WeissShahaf/LizardPlusMaze/plusmaze.PNG

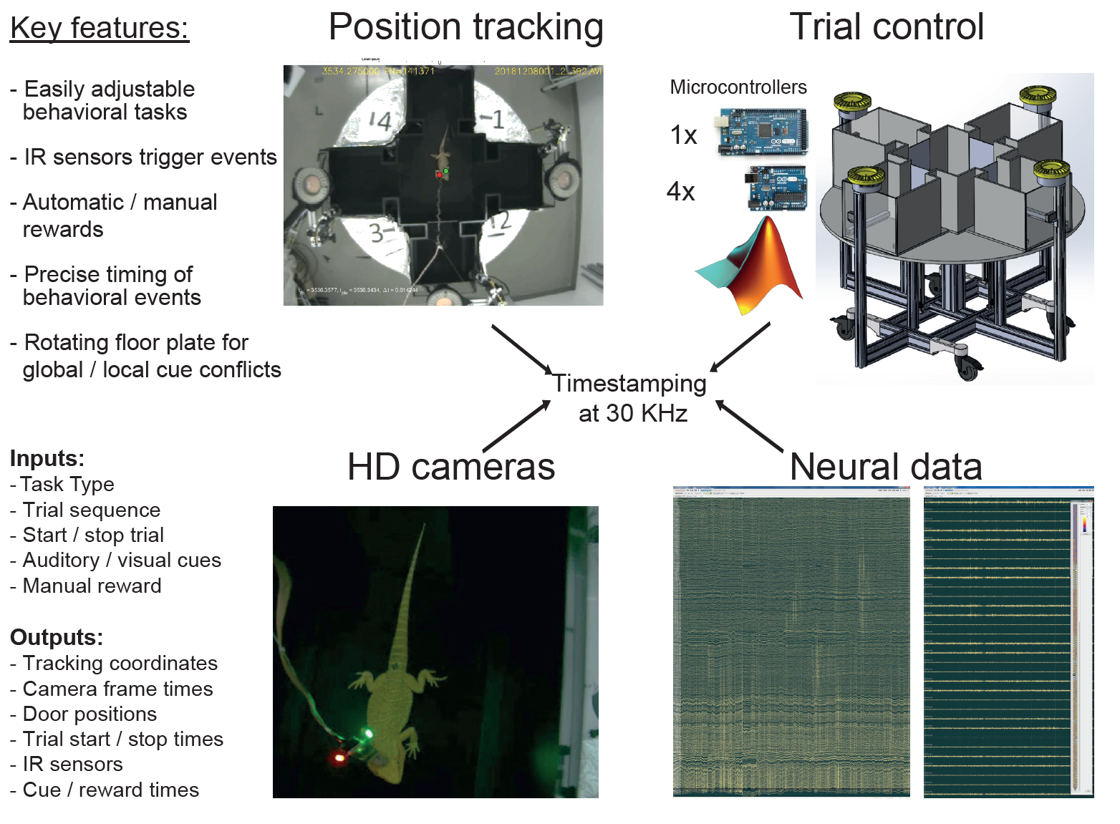
plusmaze.PNG
