WeissShahaf/LizardPlusMaze/README.md

# LizardPlusMaze
version/date: 10.04.2019
Matlab code written by Shahaf Weiss & Friedrich Kretschmer 
Arduino UNO and MEGA folders code written by Shahaf Weiss ,Friedrich Kretschmer & Erik Papuschin 
Arena design files by Guido Schmalbach

repository contains files needed to run & control plus maze arena for lizards from matlab GUI.

plusmaze
