WeissShahaf/LizardPlusMaze/MatlabCode/README.md

# LizardPlusMaze
Drivers for the lizard plus maze (in collaboration with Shahaf Weiss)
