WeissShahaf/LizardPlusMaze/documentation/GUI.pptx

GUI layout

Manual control

Programmed sequences

Program #

Load program

Save program

Dropdown menu

Name1
Name2
Name3
Start New program

Edit menu
Correct sound: 700 Hz, 50 dB
Error sound: 1400 Hz, 50 dB
Proximity setting: 10 cm
Correct arm #__
Correct light:
Error light:

TTL.IN.PLEXON.START timestamp
TTL.OUT.Doors.OPEN timestamp
TTL.OUT.Arm.1 timestamp
TTL.OUT.Correct timestamp
TTL.OUT.Reward timestamp
TTL.OUT.Doors.CLOSE timestamp
TTL.IN.PLEXON.STOP timestamp

Arm #1

Arm #2

Arm #3

Edit

Arm #4

Start

Stop

Open doors

Close doors

Run program

Stop program

Indicators layout

Correct

Error

1

4

2

3

## Slide 2

Output path:

Save as

Connect to Cheetah

Cheetah TTL events

Start recording

Animal#:free text

Task: Place/ response drop down menu

Trial | Start arm | Goal arm | Choice arm | Choice time | Comment
1 | 4 | 2 | 2 | MM:SS
2 | 3 | 2
3 | 1 | 2
4 | 3 | 2
5 | 1 | 2
6 | 4 | 2
7 | 1 | 2
8 | 4 | 2
9 | 3 | 2
10 | 1 | 2

TTL.IN.PLEXON.START timestamp
TTL.OUT.Doors.OPEN timestamp
TTL.OUT.Arm.1 timestamp
TTL.OUT.Correct timestamp
TTL.OUT.Reward timestamp
TTL.OUT.Doors.CLOSE timestamp
TTL.IN.PLEXON.STOP timestamp

Connect to Arduinos

Correct

Start Trial

No choice

End Trial

Indicators layout

1

Error

4

3

2

Stop recording

Live plot indicating current:
Door status, Start/goal/error ,Reward given/ error detected, IR activated

IR sensor : 1/2/3 drop down menu

Doors

state

Arm1

Start/Error/Goaldrop down menu

Arm2

Start/Error/Goaldrop down menu

Arm3

Start/Error/Goaldrop down menu

Arm4

Start/Error/Goaldrop down menu

## Slide 3

Output path: default: storage3\weissShahaf\plus_maze\

Day integer | Experimenter | Animal ID text | Task type drop down | Max trial time number | Temp number | Comment text
20180620 | SW | GLL00392 | Place / response / Visual Cue | Default 10 (minutes) | 27

Trial integer | IR position Drop down | Start arm integer | Goal arm integer | Choice arm integer | latency to choice | Comment text
1 | 1/2/3 | 4 | 2 | 2 If max time- autofill “5” | MM:SS autofill from 1st IR . Or NaN if no choice made
2 | | 3 | 2
3 | | 1 | 2
4 | | 3 | 2
5 | | 1 | 2
6 | | 4 | 2
7 | | 1 | 2
8 | | 4 | 2
9 | | 3 | 2
10 | | 1 | 2
…
20

Reset

Connect to Cheetah-check Netcom connection

Start cheetah recording

Connect to Arduinos
Check Serial ports

Stop cheetah recording

Static parameters

Generates table values

Trial parameters

Add trial

Start Trial

Cheetah Connected ON/OFF

Cheetah recording ON/OFF

Arduino connection
ON/OFF

Waiting/
Trial

End Trial

Changes apply to
upcoming trials

Save

Door open / closed

Arm is start/error/goal
Sensors active/inactive

1

4

2

3

Reward ON/OFF

Notes: Can combine ready and start

On save, creates folders in Output path:
path\animal\day\HH_MM_SS_cheetah
path\animal\day\HH_MM_SS_videos
path\animal\day\HH_MM_SS_behavior<- save .mat file here
On START Apply current line parameters to the maze

After END, set all arms as starting arm- do not give reward/error signals

Place task- starting arm should pseudorandomized to contain similar ratios of arms (1:3) on every 3 trials. For 10/20 trials
Goal arm is 2

Response task- starting arm should pseudorandomized to contain similar ratios of arms (1:4) on every 4 trials. For 10/20 trials
Goal arm is start arm-1 except for arm 1->goal is 4

Cue task- start and goal are randomized, cannot be equal, reward light is ON for the goal arm, and flashes when animal enters arm (requires connection to UNOs)

Start after start / end after end should have no effect! And no TTLs sent!
Start/stop cheetah should be ignored if already pressed

Highlight current trial line

Plot should update for changes in: Door status, Start/goal/error ,Reward given/ error detected, IR activated

Autosave table info to temp file on “E:\temp_maze_files” drive every 5 minutes ? Will slow down the PC too much?
