WeissShahaf/LizardPlusMaze/MazeDesignFiles/PinLayouts/arduino pinlayout.xlsx

Arduino UNO |  | Arduino Mega
Digital Pin |  | Digital Pin
0 | NC | 0 | NC
1 | NC | 1 | NC
2 | Switch Arm | 2 | Input door 1 open
3 | Motor pwmA | 3 | Input door 1 close
4 | Switch Analogsensor 1 | 4 | Input door 2 open
5 | Switch Analogsensor 2 | 5 | Input door 2 close
6 | Green LED | 6 | Input door 3 open
7 | Buzzer | 7 | Input door 3 close
8 | Signal motor drive | 8 | Input door 4 open
9 | Analogsensor active | 9 | Input door 4 close
10 | Switch Analogsensor 3 | 10 | start_arm_1
11 | Motor pwmB | 11 | start_arm_2
12 | Motor direction A | 12 | start_arm_3
13 | Motor direction B | 13 | NC
 |  | 14 | NC
 |  | 15 | NC
Analog Pin |  | 16 | NC
A0 | Signal from analogsensor 1 | 17 | NC
A1 | Signal from analogsensor 2 | 18 | NC
A2 | Signal from analogsensor 3 | 19 | NC
A3 | NC | 20 | NC
A4 | NC | 21 | NC
A5 | NC | 22 | Output door 1 open
 |  | 23 | Output door 1 close
 |  | 24 | Output door 2 open
 |  | 25 | Output door 2 close
 |  | 26 | Output door 3 open
 |  | 27 | Output door 3 close
 |  | 28 | Output door 4 open
 |  | 29 | Output door 4 close
 |  | 30 | NC
 |  | 31 | NC
 |  | 32 | NC
 |  | 33 | NC
 |  | 34 | NC
 |  | 35 | NC
 |  | 36 | NC
 |  | 37 | NC
 |  | 38 | NC
 |  | 39 | Select analogsensor 1
 |  | 40 | Select analogsensor 2
 |  | 41 | Select analogsensor 3
 |  | 42 | target_arm_1
 |  | 43 | target_arm_2
 |  | 44 | target_arm_3
 |  | 45 | target_arm_4
 |  | 46 | TRIAL_START
 |  | 47 | TRIAL_END
 |  | 48 | start_arm_4
 |  | 49 | NC
 |  | 50 | NC
 |  | 51 | NC
 |  | 52 | NC
 |  | 53 | NC
