WeissShahaf/LizardPlusMaze/MazeDesignFiles/PinLayouts/Verkabelung.xlsx

Arduino Pin | 1: D-SUB 15 Buchse Futterautomat |  |  |  |  | RGB Led | Farbe
 |  |  |  |  |  | Pin
 | Pin: | Bezeichnung: | Farbe: |  |  | Din Arduino Pin | Rot
1 | 1 | 5V | Rot |  |  | 5V | Gruen
8-10 | 2 | 5V Analog Sensor 1 | Rot |  |  | GND | Schwarz
 | 3 | 5V Analog Sensor 2 | Rot
 | 4 | 5V Analog Sensor 3 | Rot
 | 5 | NC
 | 6 | NC
6 | 7 | NC
7 | 8 | NC
3 | 9 | Signal Analogsensor 1 | Grau
4 | 10 | Signal Analogsensor 2 | Braun
5 | 11 | Signal Analogsensor 3 | Gelb
 | 12 | GND | Schwarz
 | 13 | GND Analogsensor 1 | Schwarz
 | 14 | GND Analogsensor 2 | Schwarz
 | 15 | GND Analogsensor 3 | Schwarz
 | 2: D-SUB 15 Stecker Futterautomat |  |  |  | 7: D-SUB 15 Stecker Arduino Mega Box |  |  |  |  | 3: D-SUB 25 Stecker Arudino Mega BoX |  |  | 5: D-SUB 25 Buchse Control BoX
 | Pin: | Bezeichnung: |  |  | Pin: | Bezeichnung: |  |  | Pin: | Pin: | Bezeichnung: |  | Pin: | Bezeichnung:
 | 1 | 5V Arm/Motor drehen | ← |  | 1 | 5V Arm | ← | 3: D-SUB 25 Stecker Arudino Mega BoX | 1-8 | 1 | 5V | ← | 1 | 5V
 | 2 | Matlab UI Arm 1-4 AI3 |  |  | 2 | Matlab UI Arm 1-4 AI3 |  |  |  | 2 | 5V | ← | 2 | 5V
 | 3 | Freigabe Analog Sensor 1 | ← |  | 3 | Freigabe Analog Sensor 1 | ← | 3: D-SUB 25 Stecker Arudino Mega BoX | 17 | 3 | 5V | ← | 3 | 5V
 | 4 | Freigabe Analog Sensor 2 | ← |  | 4 | Freigabe Analog Sensor 2 | ← | 3: D-SUB 25 Stecker Arudino Mega BoX | 18 | 4 | 5V | ← | 4 | 5V
 | 5 | Freigabe Analog Sensor 3 | ← |  | 5 | Freigabe Analog Sensor 3 | ← | 3: D-SUB 25 Stecker Arudino Mega BoX | 19 | 5 | Signal Arm#1 | ← | 5 | Signal Arm#1
 | 6 | Ziel Arm | ← |  | 6 | Ziel Arm | ← | 4: D-SUB 25 Buchse Arudino Mega BoX | 17-20 | 6 | Signal Arm#2 | ← | 6 | Signal Arm#2
 | 7 | Led/Buzzer Arm | → |  | 7 | Led/Buzzer Arm | → | 4: D-SUB 25 Buchse Arudino Mega BoX | 1-8 | 7 | Signal Arm#3 | ← | 7 | Signal Arm#3
 | 8 | lichtschranken | → |  | 8 | lichtschranken | → | 4: D-SUB 25 Buchse Arudino Mega BoX | 1-8 | 8 | Signal Arm#4 | ← | 8 | Signal Arm#4
 | 9 | 9V |  |  | 9 |  |  |  |  | 9 | Door 1 open | ← | 9 | Door 1 open
 | 10 | 9V |  |  | 10 |  |  |  |  | 10 | Door 1 close | ← | 10 | Door 1 close
 | 11 | 9V |  |  | 11 |  |  |  |  | 11 | Door 2 open | ← | 11 | Door 2 open
 | 12 | Matlab UI Arm 1-4 AI4 |  |  | 12 | Matlab UI Arm 1-4 AI4 |  |  |  | 12 | Door 2 close | ← | 12 | Door 2 close
 | 13 | GND |  |  | 13 |  |  |  |  | 13 | Door 3 open | ← | 13 | Door 3 open
 | 14 | GND | ← |  | 14 | GND | ← | 3: D-SUB 25 Stecker Arudino Mega BoX | 20-23 | 14 | Door 3 close | ← | 14 | Door 3 close
 | 15 | GND | ← |  | 15 | GND | ← | 3: D-SUB 25 Stecker Arudino Mega BoX | 20-23 | 15 | Door 4 open | ← | 15 | Door 4 open
 |  |  |  |  |  |  |  |  |  | 16 | Door 4 close | ← | 16 | Door 4 close
 |  |  |  |  |  |  |  |  |  | 17 | Freigabe Analog Sensor 1 | ← | 17 | Freigabe Analog Sensor 1
 |  |  |  |  |  |  |  |  |  | 18 | Freigabe Analog Sensor 2 | ← | 18 | Freigabe Analog Sensor 2
 |  |  |  |  |  |  |  |  |  | 19 | Freigabe Analog Sensor 3 | ← | 19 | Freigabe Analog Sensor 3
 | 8: Arduino Mega |  |  |  |  |  |  |  |  | 20 | GND Arm#1 | ← | 20 | GND Arm#1
 |  |  |  |  |  |  |  |  |  | 21 | GND Arm#1 | ← | 21 | GND Arm#1
 | Pin: | Bezeichnung: |  |  |  |  | Pin: |  |  | 22 | GND Arm#2 | ← | 22 | GND Arm#2
 | 0 | NC |  |  |  |  |  |  |  | 23 | GND Arm#2 | ← | 23 | GND Arm#2
 | 1 | NC |  |  |  |  |  |  |  | 24 | GND | ← | 24 | GND
 | 2 | Eingang Door 1 open | ← | 3: D-SUB 25 Stecker Arudino Mega BoX |  |  | 9 |  |  | 25 | GND | ← | 25 | GND
 | 3 | Eingang Door 1 close | ← | 3: D-SUB 25 Stecker Arudino Mega BoX |  |  | 10
 | 4 | Eingang Door 2 open | ← | 3: D-SUB 25 Stecker Arudino Mega BoX |  |  | 11
 | 5 | Eingang Door 2 close | ← | 3: D-SUB 25 Stecker Arudino Mega BoX |  |  | 12 |  |  |  |  |  |  |  | r
 | 6 | Eingang Door 3 open | ← | 3: D-SUB 25 Stecker Arudino Mega BoX |  |  | 13 |  |  | 4: D-SUB 25 Buchse Arudino Mega BoX |  |  | 6: D-SUB 25 Stecker Control BoX
 | 7 | Eingang Door 3 close | ← | 3: D-SUB 25 Stecker Arudino Mega BoX |  |  | 14
 | 8 | Eingang Door 4 open | ← | 3: D-SUB 25 Stecker Arudino Mega BoX |  |  | 15 |  |  | Pin: | Bezeichnung: |  | Pin: | Bezeichnung:
 | 9 | Eingang Door 4 close | ← | 3: D-SUB 25 Stecker Arudino Mega BoX |  |  | 16 |  |  | 1 | Led/Buzzer Arm#1 | → | 1 | Led/Buzzer Arm#1
 | 10 | Ziel Arm 1 | → | UNO |  |  |  |  |  | 2 | Feeder Sensor Arm#1 | → | 2 | Feeder Sensor Arm#1
 | 11 | Ziel Arm 2 | → | UNO |  |  |  |  |  | 3 | Led/Buzzer Arm#2 | → | 3 | Led/Buzzer Arm#2
 | 12 | Ziel Arm 3 | → | UNO |  |  |  |  |  | 4 | Feeder Sensor Arm#2 | → | 4 | Feeder Sensor Arm#2
 | 13 | Reserve |  |  |  |  |  |  |  | 5 | Led/Buzzer Arm#3 | → | 5 | Led/Buzzer Arm#3
 | 14 | Matlab UI Arm 1 AI3 | → | UNO |  |  |  |  |  | 6 | Feeder Sensor Arm#3 | → | 6 | Feeder Sensor Arm#3
 | 15 | Matlab UI Arm 1 AI4 | → | UNO |  |  |  |  |  | 7 | Led/Buzzer Arm#4 | → | 7 | Led/Buzzer Arm#4
 | 16 | Matlab UI Arm 2 AI3 | → | UNO |  |  |  |  |  | 8 | Feeder Sensor Arm#4 | → | 8 | Feeder Sensor Arm#4
 | 17 | Matlab UI Arm 2 AI4 | → | UNO |  |  |  |  |  | 9 | Feedback Door 1 open | → | 9 | Feedback Door 1 open
 | 18 | Matlab UI Arm 3 AI3 | → | UNO |  |  |  |  |  | 10 | Feedback Door 1 close | → | 10 | Feedback Door 1 close
 | 19 | Matlab UI Arm 3 AI4 | → | UNO |  |  |  |  |  | 11 | Feedback Door 2 open | → | 11 | Feedback Door 2 open
 | 20 | NC |  |  |  |  |  |  |  | 12 | Feedback Door 2 close | → | 12 | Feedback Door 2 close
 | 21 | NC |  |  |  |  |  |  |  | 13 | Feedback Door 3 open | → | 13 | Feedback Door 3 open
 | 22 | Door 1 open | → | Door 1 |  |  |  |  |  | 14 | Feedback Door 3 close | → | 14 | Feedback Door 3 close
 | 23 | Door 1 close | → | Door 1 |  |  |  |  |  | 15 | Feedback Door 4 open | → | 15 | Feedback Door 4 open
 | 24 | Door 2 open | → | Door 2 |  |  |  |  |  | 16 | Feedback Door 4 close | → | 16 | Feedback Door 4 close
 | 25 | Door 2 close | → | Door 2 |  |  |  |  |  | 17 | Ziel Arm 1 | → | 17 | Ziel Arm 1
 | 26 | Door 3 open | → | Door 3 |  |  |  |  |  | 18 | Ziel Arm 2 | → | 18 | Ziel Arm 2
 | 27 | Door 3 close | → | Door 3 |  |  |  |  |  | 19 | Ziel Arm 3 | → | 19 | Ziel Arm 3
 | 28 | Door 4 open | → | Door 4 |  |  |  |  |  | 20 | Ziel Arm 4 | → | 20 | Ziel Arm 4
 | 29 | Door 4 close | → | Door 4 |  |  |  |  |  | 21 | GND Arudino Mega Platinr | → | 21 | GND Arudino Mega Platinr
 | 30 | Feedback Door 4 close | → | 4: D-SUB 25 Buchse Arudino Mega BoX |  |  | 16 |  |  | 22 | GND Arudino Mega Platinr | → | 22 | GND Arudino Mega Platinr
 | 31 | Feedback Door 4 open | → | 4: D-SUB 25 Buchse Arudino Mega BoX |  |  | 15 |  |  | 23 | GND Arm#3 | → | 23 | GND Arm#3
 | 32 | Feedback Door 3 close | → | 4: D-SUB 25 Buchse Arudino Mega BoX |  |  | 14 |  |  | 24 | GND Arm#4 | → | 24 | GND Arm#4
 | 33 | Feedback Door 3 open | → | 4: D-SUB 25 Buchse Arudino Mega BoX |  |  | 13 |  |  | 25 | GND Arm#4 | → | 25 | GND Arm#4
 | 34 | Feedback Door 2 close | → | 4: D-SUB 25 Buchse Arudino Mega BoX |  |  | 12
 | 35 | Feedback Door 2 open | → | 4: D-SUB 25 Buchse Arudino Mega BoX |  |  | 11
 | 36 | Feedback Door 1 close | → | 4: D-SUB 25 Buchse Arudino Mega BoX |  |  | 10
 | 37 | Feedback Door 1 open | → | 4: D-SUB 25 Buchse Arudino Mega BoX |  |  | 9
 | 38 | Matlab UI Arm 4 AI3 | → | UNO
 | 39 | Freigabe Analog Sensor 1 | → | UNO
 | 40 | Freigabe Analog Sensor 2 | → | UNO
 | 41 | Freigabe Analog Sensor 3 | → | UNO
 | 42 | Signal Arm#1 | → | UNO
 | 43 | Signal Arm#2 | → | UNO
 | 44 | Signal Arm#3 | → | UNO
 | 45 | Signal Arm#4 | → | UNO
 | 46 | TRIAL_START | → | UNO
 | 47 | TRIAL_END | → | UNO
 | 48 | Ziel Arm 4 | → | UNO
 | 49 | Matlab UI Arm 4 AI4 | → | UNO
 | 50 | NC
 | 51 | NC
 | 52 | NC
 | 53 | NC
 |  |  |  |  |  |  |  |  |  | D-SUB 25 Buchse Arudino Mega BoX TTL OUT |  |  |  | TTL BOX
 |  |  |  |  |  |  |  |  |  | Pin: | Bezeichnung: |  | Pin: | Bezeichnung:
 |  |  |  |  |  |  |  |  |  | 1 | Door 1 open |  | 1 | TRIAL_START
 |  |  |  |  |  |  |  |  |  | 2 | Door 2 open |  | 2 | TRIAL_END
 |  |  |  |  |  |  |  |  |  | 3 | Door 3 open |  | 3 | Door 1 open
 |  |  |  |  |  |  |  |  |  | 4 | Door 4 open |  | 4 | Door 2 open
 |  |  |  |  |  |  |  |  |  | 5 | Reserve 1 |  | 5 | Door 3 open
 |  |  |  |  |  |  |  |  |  | 6 | LSARM1_ACTIVE |  | 6 | Door 4 open
 |  |  |  |  |  |  |  |  |  | 7 | LSARM2_ACTIVE |  | 7 | LSARM1_ACTIVE
 |  |  |  |  |  |  |  |  |  | 8 | LSARM3_ACTIVE |  | 8 | LSARM2_ACTIVE
 |  |  |  |  |  |  |  |  |  | 9 | LSARM4_ACTIVE |  | 9 | LSARM3_ACTIVE
 |  |  |  |  |  |  |  |  |  | 10 | Reserve 2 |  | 10 | LSARM4_ACTIVE
 |  |  |  |  |  |  |  |  |  | 11 | FEEDER1_ACTIVE |  | 11 | FEEDER1_ACTIVE
 |  |  |  |  |  |  |  |  |  | 12 | FEEDER2_ACTIVE |  | 12 | FEEDER2_ACTIVE
 |  |  |  |  |  |  |  |  |  | 13 | FEEDER3_ACTIVE |  | 13 | FEEDER3_ACTIVE
 |  |  |  |  |  |  |  |  |  | 14 | FEEDER4_ACTIVE |  | 14 | FEEDER4_ACTIVE
 |  |  |  |  |  |  |  |  |  | 15 |  |  | 15 | Reserve 1
 |  |  |  |  |  |  |  |  |  | 16 | TRIAL_START |  | 16 | Reserve 2
 |  |  |  |  |  |  |  |  |  | 17 | TRIAL_END
 |  |  |  |  |  |  |  |  |  | 18
 |  |  |  |  |  |  |  |  |  | 19
 |  |  |  |  |  |  |  |  |  | 20 | GND
 |  |  |  |  |  |  |  |  |  | 21 | GND
 |  |  |  |  |  |  |  |  |  | 22 | GND
 |  |  |  |  |  |  |  |  |  | 23 | GND
 |  |  |  |  |  |  |  |  |  | 24 | GND
 |  |  |  |  |  |  |  |  |  | 25 | GND
