WeissShahaf/LizardPlusMaze/documentation/parts/NLX_PLX.pptx

Basler and behavioral TTLs going to Neuralynx

Plexon signal going into Basler cameras

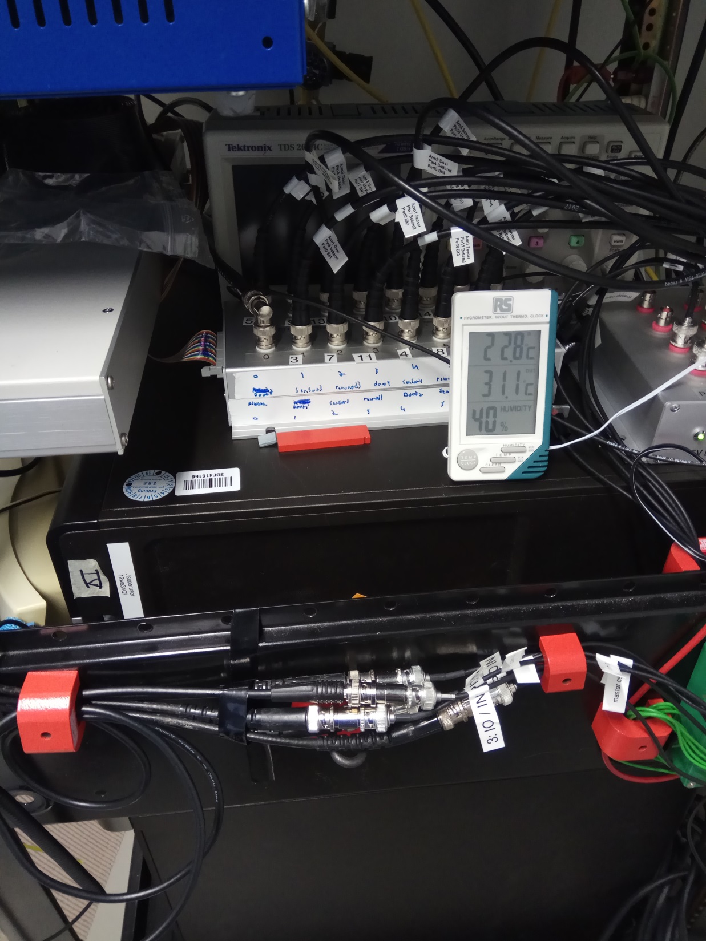
[picture p3: figure]

## Slide 2

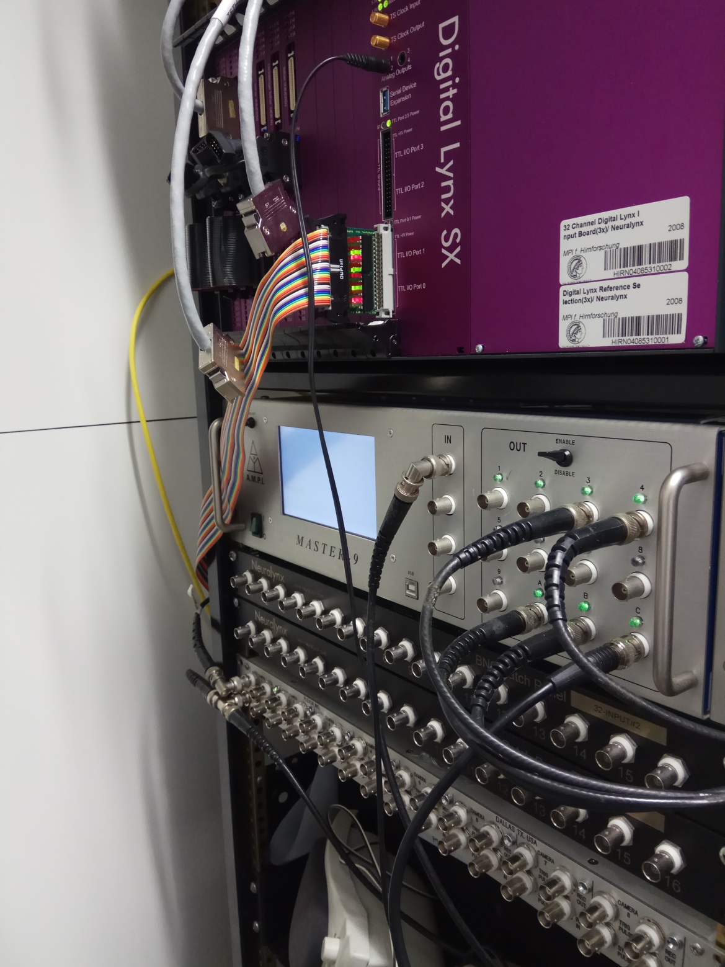
[picture p4: figure]

Signal split to activate Basler cameras

PLEXON frame TTL IN

PLEXON OUT
To Basler cameras

PLEXON OUT TTL
to Neuralynx
