WeissShahaf/LizardPlusMaze/documentation/parts/electronics parts list.xlsx

Sheet: Materialkostenrechnung
 |  | Vorbereitung Bestellung und Materialkostenrechnung
Bestell- datum | Bedarfsanforderung | Bezug (Lager/EK) | Distributor | Beschreibung | Bestell-Nr. | Stück | Einzel-preis | Gesamtpreis Netto | Bemerkung
 |  |  |  |  |  |  |  | 0.00 €
 |  |  |  | Kostenstelle 3210: Eigenverbrauch Elektronik-Werkstatt |  |  |  | 0.00 €
 |  |  |  | Kostenstelle 3211: Wissenschaftlicher Auftrag |  |  |  | 0.00 €
2018-01-30 | 2002799406 | EK | EXP | SparkFun RGB und Gesten-Sensor (APDS- | EXP-R05-420 | 2 | 11.93 € | 23.86 €
2018-02-06 | 2002809236 | EK | MM-Aquaristik | Grässling Rundomatic 400 | 90-GR-0001 | 2 | 55.90 € | 111.80 €
 |  |  |  |  |  |  |  | 0.00 €
2018-03-12 | 2002852921 | EK | Distrelec | Microcontroller Board, Mega2560, R3, A000067, ATmega2560, A000067, Arduino | 110-38-920 | 1 | 34.96 € | 34.96 €
2018-03-12 | 2002852921 | EK | Distrelec | Arduino Motor Shield R3, A000079, SHIELD MODEL MOTOR, Arduino | 110-38-926 | 4 | 19.73 € | 78.92 €
2018-03-12 | 2002852921 | EK | Distrelec | Mikrocontroller Board, Uno, A000066, ATmega328, A000066, Arduino | 110-38-919 | 4 | 19.61 € | 78.44 €
2018-03-12 | 2002852921 | EK | Distrelec | Gehäusehälfte 220 mm | 150-69-916 | 1 | 11.60 € | 11.60 €
2018-03-12 | 2002852921 | EK | Distrelec | Gehäusehälfte 220 mm | 150-69-899 | 2 | 11.01 € | 22.02 €
2018-03-12 | 2002852921 | EK | Distrelec | Front-/ Rückplatte | 150-69-921 | 2 | 8.04 € | 16.08 €
2018-03-12 | 2002852921 | EK | Distrelec | Grove - Summer, Arduino, Raspberry Pi, BeagleBone, Edison, LaunchPad, Mbed, Galiel, 107020000, Seeed Studio | 300-69-924 | 4 | 1.63 € | 6.52 €
2018-03-12 | 2002852921 | EK | Distrelec | LED 5 mm (T13/4) rot/grün/blau Dreifarbig | 175-50-380 | 5 | 0.75 € | 3.75 €
2018-03-12 | 2002852921 | EK | Distrelec | LED 5 mm (T13/4) rot/grün/blau Dreifarbig | 175-10-222 | 5 | 1.93 € | 9.65 €
2018-03-12 | 2002852921 | EK | Distrelec | LED 5 mm (T13/4) rot/grün/blau Dreifarbig | 175-10-221 | 5 | 1.93 € | 9.65 €
2018-03-12 | 2002852921 | EK | Distrelec | Logic-IC SOIC-14, CD4081, CD4081BM, Texas Instruments | 300-18-498 | 10 | 0.20 € | 2.00 €
2018-03-12 | 2002852921 | EK | Distrelec | Logic-IC SC-70-5, SN74AHC1G00, SN74AHC1G00DCKR, Texas Instruments | 300-22-896 | 10 | 0.34 € | 3.40 €
2018-03-12 | 2002852921 | EK | Distrelec | Widerstandsnetzwerk SIL 10 kOhm ± 2 %, 4609X-101-103LF, Bourns | 160-32-478 | 10 | 0.29 € | 2.90 €
2018-03-12 | 2002852921 | EK | Distrelec | Treiber-ICs DIL-18, ULN2803A, ST | 173-13-323 | 3 | 0.50 € | 1.50 €
2018-03-12 | 2002852921 | EK | Distrelec | Präz.-IC-Sockel, DIL 18, 110-87-318-41-001, Preci-Dip | 148-14-802 | 3 | 0.61 € | 1.83 €
2018-03-12 | 2002852921 | EK | Distrelec | Offene Sicherungshalter ø 5 x 20 mm, PTF/15, Stelvio-Kontek | 133-15-017 | 10 | 0.27 € | 2.70 €
2018-03-12 | 2002852921 | EK | Distrelec | Sicherung 5 x 20 mm: 0.125 A flink, RND 17000072, RND Components | 300-43-492 | 10 | 0.15 € | 1.50 €
2018-03-12 | 2002852921 | EK | Distrelec | Leiterplatte Epoxyd 233 x 160 mm | 149-55-332 | 5 | 7.24 € | 36.20 €
2018-03-12 | 2002852921 | EK | Distrelec | Stiftleiste Male 8, RND 205-00629, RND Connect | 300-93-649 | 10 | 0.17 € | 1.70 €
2018-03-12 | 2002852921 | EK | Distrelec | Stiftleiste Male 10, RND 205-00631, RND Connect | 300-93-651 | 10 | 0.22 € | 2.20 €
2018-03-12 | 2002852921 | EK | Distrelec | Stiftleiste Male 36 zweireihig / gerade / ohne Schutzkragen, 61303621121, Würth Elektronik | 300-24-556 | 2 | 1.00 € | 2.00 €
2018-03-12 | 2002852921 | EK | Distrelec | Netzgeräte 24 VDC/2.5 A, OWA-60E-24, Mean Well | 300-43-981 | 1 | 24.37 € | 24.37 €
2018-03-12 | 2002852921 | EK | Distrelec | Konfektioniertes Kabel 3 M8 Buchse M8 Stecker 2 m, 21348081380020, HARTING | 300-34-340 | 8 | 7.03 € | 56.24 €
2018-03-12 | 2002852921 | EK | Distrelec | Stiftleiste Male 6, 6410-06A / 2227-2061, Molex | 143-80-838 | 10 | 0.23 € | 2.30 €
2018-03-12 | 2002852921 | EK | Distrelec | Crimpgehäuse Female 6, 6471-061 / 2201-2065, Molex | 143-80-432 | 10 | 0.12 € | 1.20 €
2018-03-12 | 2002852921 | EK | Distrelec | Crimpkontakt Female 30...22 AWG, 4809C-P914L / 0850-0032, Molex | 143-80-598 | 100 | 0.02 € | 2.00 €
2018-03-12 | 2002853041 | EK | RS | Vishay Optokoppler, 60 mA DC Input Phototransistor Output, 5 kV eff PCB-Montage, DIP 4-Pin | 773-3693 | 10 | 0.17 € | 1.74 €
2018-03-12 | 2002853041 | EK | RS | Murr Elektronik Serie 7000 Stecker gerade, Buchse 3-polig, Buchsenkontakte Crimpanschluss, 4A, Steckbar | 827-2770 | 20 | 7.74 € | 154.78 €
2018-03-12 | 2002853041 | EK | RS | Murr Elektronik Serie 7000 Stecker gerade, Stecker 3-polig, Stiftkontakte, 4A, Steckbar | 797-5768 | 10 | 8.07 € | 80.70 €
2018-03-12 | 2002853041 | EK | RS | Mutter, 718 Serie, M8 x 0.5, für Rundsteckverbinder, Metall | 706-3165 | 20 | 0.94 € | 18.78 €
2018-03-12 | 2002853041 | EK | RS | Lumberg USB 2.0 Kabel schwarz, Stecker USB A / Stecker USB B, Länge 5m | 737-8818 | 1 | 10.62 € | 10.62 €
2018-03-12 | 2002853041 | EK | RS | DC-Adapter gerade 5A, Kabelmontage, Länge 57.1mm, vernickelt, IP68 | 705-1519 | 1 | 8.82 € | 8.82 €
2018-03-12 | 2002853041 | EK | RS | DC Buchse 2,5mm gerade Tafelmontage 5A 30 V dc versilbert, IP68 | 705-1525 | 1 | 7.89 € | 7.89 €
2018-03-12 | 2002853041 | EK | RS | USB-Adapter USB 2.0 A, USB 2.0 B, Buchse auf Buchse, gerade, Tafelmontage | 907-5628 | 1 | 7.21 € | 7.21 €
2018-03-12 | 2002853041 | EK | RS | 0.5MTR USB 2.0 A M B M BLACK | 121-6576 | 1 | 2.08 € | 2.08 €
2018-03-12 | 2002853041 | EK | RS | Nylon Leiterplattenstift, PCB-Stärke 1,6mm, Höhe 9.5mm, PCB-Bohrung 3,2mm | 663-3417 | 40 | 0.15 € | 6.00 €
2018-03-12 | 2002853041 | EK | RS | Nylon Leiterplattenstift, PCB-Stärke 1,6mm, Höhe 11.1mm, PCB-Bohrung 3,2mm | 663-3426 | 40 | 0.15 € | 6.00 €
2018-03-12 | 2002853041 | EK | RS | Arcolectric R13112AAAA Wippschalter 1-poliger Ein-/Ausschalter, schwarz | 314-4995 | 2 | 1.69 € | 3.37 €
 |  |  |  |  |  |  |  | 0.00 €
2018-03-12 | 2002853155 | EK | EXP | 2x3 6 Pin Stackable Header für Arduino | EXP-T01-017 | 7 | 0.40 € | 2.79 €
2018-03-12 | 2002853155 | EK | EXP | Arduino Stackable Header - 8 Pin | EXP-R05-017 | 8 | 0.44 € | 3.50 €
2018-03-12 | 2002853155 | EK | EXP | Arduino Stackable Header - 10 Pin | EXP-R05-563 | 2 | 0.44 € | 0.87 €
2018-03-12 | 2002853155 | EK | EXP | Addressable Through-Hole 5mm RGB LED with Diffused Lens, WS2811 Driver (10-Pack) | EXP-R25-679 | 1 | 4.31 € | 4.31 €
 |  |  |  |  |  |  |  | 0.00 €
2018-03-23 | 2002868594 | EK | RS | Nylon Leiterplatten Abstandshalter verriegelnd, PCB-Stärke 1,6mm, Höhe 3.2mm, Bohrung Ø 3.18mm | 663-3312 | 40 | 0.17 € | 6.60 €
2018-03-23 | 2002868594 | EK | RS | Stahl Stirnrad 12 Zähne, Modul 0.5, Teilungs-Ø 6mm, Naben-Ø 8mm, Bohrung 3mm | 878-7819 | 3 | 13.99 € | 41.97 €
2018-03-23 | 2002868641 | EK | Conrad | Abstandsbolzen (L) 50 mm M3x7 M3x6 Stahl verzinkt PB Fastener S45530X50 10 St. | 521742 | 4 | 2.85 € | 11.40 €
2018-03-23 | 2002868641 | EK | Conrad | Abstandsbolzen (L) 5 mm M3x5 Stahl verzinkt PB Fastener S55530X05 10 St. | 521624 | 4 | 1.56 € | 6.24 €
2018-03-23 | 2002868641 | EK | Conrad | Abstandsbolzen (L) 10 mm M3x10 Stahl verzinkt PB Fastener S55530X10 10 St. | 521636 | 4 | 1.63 € | 6.52 €
2018-03-23 | 2002868641 | EK | Conrad | Distanz-Sensor 1 St. GP2Y0A41SK0F Sharp 5 V/DC Reichweite max. (im Freifeld): 30 cm | 504596 | 3 | 15.04 € | 45.12 €
2018-03-23 | 2002868641 | EK | Conrad | D-SUB Buchsenleiste 180 ° Polzahl: 15 Lötkelch econ connect BU15LK/V 1 St. | 1303822 | 10 | 0.33 € | 3.30 €
2018-03-23 | 2002868641 | EK | Conrad | D-SUB Stiftleiste 180 ° Polzahl: 15 Lötkelch econ connect ST15LK/V 1 St. | 1303913 | 10 | 0.34 € | 3.40 €
2018-03-23 | 2002868641 | EK | Conrad | D-SUB Stiftleisten-Set 180 ° Polzahl: 15 Lötkelch encitech DTNT15-M-DBP-K 1 Set | 1508741 | 4 | 3.28 € | 13.12 €
2018-03-23 | 2002868736 | EK | Distrelec | Gehäusehälfte 220 mm, KOH14220ME, Fischer Elektronik | 150-69-901 | 2 | 14.89 € | 29.78 €
2018-03-23 | 2002868736 | EK | Distrelec | Front-/ Rückplatte, DKOH02KOH14ME, Fischer Elektronik | 150-69-923 | 2 | 10.39 € | 20.78 €
2018-04-04 | 2002878771 | EK | Conrad | D-SUB Buchse 180 ° Polzahl: 25 Löten Connfly 1 St. | 1389965 | 4 | 0.31 € | 1.24 €
2018-04-04 | 2002878771 | EK | Conrad | D-SUB Stecker 180 ° Polzahl: 25 Löten Connfly 1 St. | 1389980 | 4 | 0.25 € | 1.00 €
2018-04-04 | 2002878771 | EK | Conrad | Distanz-Sensor 1 St. GP2Y0A41SK0F Sharp 5 V/DC Reichweite max. (im Freifeld): 30 cm | 504596 | 9 | 15.04 € | 135.36 €
2018-04-04 | 2002878771 | EK | Conrad | Kippschalter 250 V/AC 3 A 1 x Ein/Ein APEM 5236A / 52360003 rastend 1 St. | 700153 | 7 | 2.22 € | 15.54 €
2018-04-04 | 2002878771 | EK | Conrad | Kippschalter 250 V/AC 3 A 2 x Ein/Ein APEM 5246A / 52460003 rastend 1 St. | 700192 | 5 | 3.03 € | 15.15 €
2018-04-04 | 2002878771 | EK | Conrad | LED-Signalleuchte Weiß 3.6 V 20 mA SCI R9-103L-12-WD | 149775 | 5 | 1.58 € | 7.90 €
2018-04-04 | 2002878771 | EK | Conrad | LED-Signalleuchte Grün 2.1 V 20 mA SCI R9-3612, GREEN | 149782 | 5 | 0.83 € | 4.15 €
2018-04-04 | 2002878771 | EK | Conrad | Niedervolt-Steckverbinder Buchse, Einbau vertikal 5.7 mm 2.1 mm BKL Electronic 072339 1 St. | 1460765 | 2 | 1.66 € | 3.32 €
2018-04-04 | 2002878771 | EK | Conrad | LED-Fassung Kunststoff Passend für LED 5 mm SnapIn Kingbright | 178942 | 20 | 0.19 € | 3.80 €
 |  |  |  |  |  |  |  | 0.00 €
2018-04-19 | 2002898122 | EK | RS | USB-Steckverbinder Typ B, Buchse, rechtwinklig, Durchsteckmontage, 1,5A | 725-6005 | 4 | 7.20 € | 28.80 €
2018-04-19 | 2002898122 | EK | RS | Arcolectric R13244AAAA Wippschalter 2-poliger Schließer, Ein-Aus, schwarz | 533-2986 | 1 | 2.60 € | 2.60 €
2018-04-19 | 2002898122 | EK | RS | Mean Well Notebook Netzgerät getaktet, 9Vdc / 4.45A | 667-5556 | 1 | 28.09 € | 28.09 €
2018-04-19 | 2002898122 | EK | RS | UA7805CKCS Single Positiv Spannungsregler linear, 5 V / 1.5A, TO-220 3-Pin | 661-6692 | 5 | 0.53 € | 2.67 €
2018-04-19 | 2002898122 | EK | RS | WIMA Polyesterkondensator (PET), Printmontage 330nF 40 V ac, 63 V dc ±10% | 108-2413 | 10 | 0.53 € | 5.25 €
2018-04-19 | 2002898122 | EK | RS | WIMA Polyesterkondensator (PET), Printmontage 100nF 40 V ac, 63 V dc ±20% | 115-023 | 10 | 0.37 € | 3.67 €
2018-04-19 | 2002898122 | EK | RS | Netzkabel schwarz 2,5m, C13 / Schuko, 250 V / 10 A | 731-6169 | 1 | 5.64 € | 5.64 €
2018-04-19 | 2002898122 | EK | RS | Lumberg USB 2.0 Kabel schwarz, Stecker USB A / Stecker USB B, Länge 5m | 737-8818 | 1 | 10.62 € | 10.62 €
2018-04-19 | 2002898122 | EK | RS | Apem Kippschalter SP (Ein)-Aus-Ein, 4 A @ 30 V dc | 377-9658 | 4 | 3.00 € | 12.01 €
2018-04-19 | 2002898122 | EK | RS | Kingbright THT LED grün 2 V, 60° Rund-Linse 5 mm / T-1 3/4 | 228-6004 | 15 | 0.15 € | 2.31 €
2018-04-19 | 2002898122 | EK | RS | Kingbright THT LED rot, 60° Rund-Linse 5 mm / T-1 3/4 | 228-5988 | 15 | 0.17 € | 2.61 €
 |  |  |  |  |  |  |  | 0.00 €
2018-05-02 | 2002911064 | EK | Distrelec | Gehäusehälfte 220 mm | 150-69-916 | 1 | 11.60 € | 11.60 €
2018-05-02 | 2002911064 | EK | Distrelec | Gehäusehälfte 220 mm | 150-69-898 | 1 | 8.08 € | 8.08 €
2018-05-02 | 2002911064 | EK | Distrelec | Front-/ Rückplatte | 150-69-920 | 1 | 7.45 € | 7.45 €
2018-05-02 | 2002911064 | EK | Distrelec | Gerätebuchse BNC gerade 50 Ohm, 4 G | 300-12-013 | 16 | 1.33 € | 21.28 €
2018-05-02 | 2002911064 | EK | Distrelec | Socket ø 4 mm CAT I | 140-60-109 | 5 | 1.06 € | 5.30 €
 |  |  |  |  |  |  |  | 0.00 €
2018-05-02 | 2002911109 | EK | RS | BNC-Verbindungskabel RG58 5m | 112-0903 | 16 | 10.83 € | 173.22 €
 |  |  |  |  |  |  |  | 0.00 €
2018-05-09 | 2002920169 | EK | Nanotec | Permanentmagnet- Schrittmotoren | SPG1518M0504-102 | 3 | 29.10 € | 87.30 €
 |  |  |  |  |  |  |  | 0.00 €
 |  |  |  |  |  |  |  | 0.00 €
 |  |  |  |  |  |  |  | 0.00 €
 |  |  |  |  |  |  |  | 0.00 €
Summe Lager (Abschätzung für Auftragsnachweis) |  |  |  |  |  |  |  | 0.00 €
Summe Einkauf |  |  |  |  |  |  |  | 1227.28 €
anteiliger Verschleiß Werkzeuge LPKF-Fräse (PCB-Fertigung) |  |  |  |  |  |  |  | 0.00 €
anteiliger Verschleiß Werkzeuge ISEL-Fräse (mechanische Teile, Gehäuse) |  |  |  |  |  |  |  | 0.00 €
Summe gesamt |  |  |  |  |  |  |  | 1227.28 €

Sheet: LPKF
Bezeichnung | Verbrauch | Kosten bei 100% | Kosten
 | [ % ] | bei 100% | bei Verbrauch-%
Micro-Cutter |  | 20.00 € | 0.00 €
Universal-Cutter |  | 12.00 € | 0.00 €
Spiral-Drill 0,6 |  | 3.80 € | 0.00 €
Spiral-Drill 0,7 |  | 3.80 € | 0.00 €
Spiral-Drill 0,8 |  | 3.80 € | 0.00 €
Spiral-Drill 0,9 |  | 3.80 € | 0.00 €
Spiral-Drill 1,0 |  | 3.80 € | 0.00 €
Spiral-Drill 1,2 |  | 3.80 € | 0.00 €
Spiral-Drill 2,0 |  | 3.80 € | 0.00 €
Contour Router 2,0 |  | 14.00 € | 0.00 €
ProConduct-Paste RS |  | 160.00 € | 0.00 €
ProConduct Folien |  | 79.00 € | 0.00 €
Wabenplatten |  | 57.00 € | 0.00 €
Sinterplatten |  | 89.00 € | 0.00 €
Basismaterial 1,5 mm Dicke, 35/35µm |  | 129.00 € | 0.00 €
 |  |  | 0.00 €
 |  |  | 0.00 €
 |  |  | 0.00 €
 |  |  | 0.00 €
 |  |  | 0.00 €
 |  |  | 0.00 €
Summe Werkzeug / Verbrauchsmaterial |  |  | 0.00 €

Sheet: mechanical workshop
For the cylinders see document 2200423337, Company Festo
For the Aluminium Profiles see document item-00235935-1, Company ITEM
For the Arena see document 2018-47354, Company KTD
1x Arretierbolzen (Lock pin) ordered by RS Components GmbH
1x Rundtischlager PRT-03-80 (rotary table bearings) ordered by Igus
4x Noga 3D Gelenkarm 120 (articulated arm) ordered by Hoffmann Group
1x Adapter plate Aluminium ordered by Gleich Aluminium
4x Tür (door) black anodized Aluminium by MVG (Metall Verkaufs Gesellschaft)
Rubber floor ordered by RS Components GmbH

Sheet: software
plexon cineplex studio v3
pylonRecorder
cheetah
labbook
excel
matlab
arduino
cameras | model
stingray
basler
