WeissShahaf/LizardPlusMaze/documentation/parts/2200423337.PDF

1 5

2 5

3 von Nettopreis EUR/St 5

4 5

5 von Es gelten die in unserem Katalog abgedruckten neuen Liefer- / Zahlungs- und Software- Nutzungsbedingungen. Sollten Ihnen diese nicht vorliegen, können Sie diese unter www.festo.de/lzb abrufen. 5

Für Software / Apps gilt unser End User License Agreement (EULA), abrufbar unter https://www.festo.com/cms/de_de/eula.htm . Lieferung: ab Werk Zahlung: 10 Tage 2% / 30 Tage netto zuzüglich Mehrwertsteuer
