WeissShahaf/LizardPlusMaze/documentation/inclusion_list_lizard_plusmaze.xls

Sheet: Experiments
animal | day | Task | experiment | animal_name | tracking_method | calibration_dir | NW_calib | NE_calib | SE_calib | SW_calib | arena_width_east_to_west | data_dir | video_dir | DVT_file | cheetah_dir | reference_channel | TT | depth | active_channels | use_tetrodes | throw_away_times | nsessions | use_for_sorting | use_for_analysis | start_arm | correct_arm | choices | session_1 | events_1 | time_offsets_1 | session_2 | events_2 | time_offsets_2 | session_3 | events_3 | time_offsets_3 | comments
00392 | 171208 |  | 01 | shoshana | marker | 20171215_calibration | 3344,3669 | 17964,18455 | 21615,22105 | 23668,23913 | 200 |  | 20171208_392 | 20171208_392 | 20171208_392_tmaze | 3 | 1:8 | 0 | 1,1,1,1;1,1,1,1;1,1,1,1;1,1,1,1 | 1:8 | 0,0 | 1 | 1 | 1 |  | - |  | t_maze
269 | 171211 |  | 01 | chocho | marker | 20171215_calibration | 3344,3669 | 17964,18455 | 21615,22105 | 23668,23913 | 200 |  | 20171211_269 | 20171211_269 | 20171211_269_t_maze_feederv2 | 0 | 1:8 | 0 | 1,1,1,1;1,1,1,1;1,1,1,1;1,1,1,1 | 1:8 | 0,0 | 1 | 1 | 1 |  | 1 |  | t_maze | 1,456263 | 0,0 |  |  |  |  |  |  | feeder v2
001 | 171212 |  | 01 | chocho | marker | 20171215_calibration | 3344,3669 | 17964,18455 | 21615,22105 | 23668,23913 | 200 |  | testTTL | testTTL | 20171212testTTL | 0 | 1:8 | 0 | 1,1,1,1;1,1,1,1;1,1,1,1;1,1,1,1 | 1:8 | 0,0 | 1 | 1 | 1 |  | 1 |  | t_maze | 1,3452 | 0,0
0392 | 171218 |  | 01 | shoshana | marker | 20171215_calibration | 3344,3669 | 17964,18455 | 21615,22105 | 23668,23913 | 200 |  | 20171218_392 | 20171218_392 | 20171218_392_Tmaze | 0 | 1:8 | 0 | 1,1,1,1;1,1,1,1;1,1,1,1;1,1,1,1 | 1:8 | 0,0 | 1 | 1 | 1 |  | 1 |  | t_maze | 1,522137 | 0,0
0269 | 171218 |  | 01 | chocho | marker | 20171215_calibration | 3344,3669 | 17964,18455 | 21615,22105 | 23668,23913 | 200 |  | 20171218_269_2 | 20171218_269_2 | 20171218_269_tmaze2 | 0 | 1:8 | 0 | 1,1,1,1;1,1,1,1;1,1,1,1;1,1,1,1 | 1:8 | 0,0 | 1 | 1 | 1 |  | 1 |  | t_maze | 1,267690 | 0,0
0392 | 171215 |  | 01 | shoshana | marker | 20171215_calibration | 3344,3669 | 17964,18455 | 21615,22105 | 23668,23913 | 200 |  | 20171215_392_1 | 20171215_392_1 | 20171215_392 | 0 | 1:8 | 0 | 0,0,0,0;0,0,0,0;0,0,0,0;0,0,0,0 | 1:8 | 0,0 | 1 | 1 | 1 |  | 1 |  | t_maze | 1,259049 | 0,0
0269 | 171215 |  | 01 | chocho | marker | 20171215_calibration | 3344,3669 | 17964,18455 | 21615,22105 | 23668,23913 | 200 |  | 20171215001_269 | 20171215001_269 | 20171215_269_tmaze | 0 | 1:8 | 0 | 1,1,1,1;1,1,1,1;1,1,1,1;1,1,1,1 | 1:8 | 0,0 | 1 | 1 | 1 |  | 1 |  | t_maze | 1,208768 | 0,0
0148 | 171215 |  | 01 | psycho | marker | 20171215_calibration | 3344,3669 | 17964,18455 | 21615,22105 | 23668,23913 | 200 |  | 20171215_148 | 20171215_148 | 20171215_148_tmaze | 0 | 1:8 | 0 | 1,1,1,1;1,1,1,1;1,1,1,1;1,1,1,1 | 1:8 | 0,0 | 1 | 1 | 1 |  | 1 |  | t_maze | 1,135435 | 0,0
0392 | 171212 |  | 01 | shoshana | marker | 20171215_calibration | 3344,3669 | 17964,18455 | 21615,22105 | 23668,23913 | 200 |  | 20171212_392 | 20171212_392 | 20171212_392 | 0 | 1:8 | 0 | 1,1,1,1;1,1,1,1;1,1,1,1;1,1,1,1 | 1:8 | 0,0 | 1 | 1 | 1 |  | 1 |  | t_maze | 1,311274 | 0,0
0148 | 171212 |  | 01 | chocho | marker | 20171215_calibration | 3344,3669 | 17964,18455 | 21615,22105 | 23668,23913 | 200 |  | 20171212_148 | 20171212_148 | 20171212_148_tmaze | 0 | 1:8 | 0 | 1,1,1,1;1,1,1,1;1,1,1,1;1,1,1,1 | 1:8 | 0,0 | 1 | 1 | 1 |  | 1 |  | t_maze | 1,371383 | 0,0
0392 | 171220 |  | 01 | shoshana | HSV | 20171215_calibration | 3344,3669 | 17964,18455 | 21615,22105 | 23668,23913 | 200 |  | 20171220_392 | 20171220_392 | 20171220_392_tmaze | 0 | 1:8 | 0 | 1,1,1,1;1,1,1,1;1,1,1,1;1,1,1,1 | 1:8 | 0,0 | 1 | 1 | 1 |  | 1 |  | t_maze | 1,559604 | 0,0
0269 | 171220 |  | 01 | chocho | HSV | 20171215_calibration | 3344,3669 | 17964,18455 | 21615,22105 | 23668,23913 | 200 |  | 20171220_269 | 20171220_269 | 20171220_269_tmaze | 0 | 1:8 | 0 | 1,1,1,1;1,1,1,1;1,1,1,1;1,1,1,1 | 1:8 | 0,0 | 1 | 1 | 1 |  | 1 |  | t_maze | 1,391545 | 0,0
0251 | 171220 |  | 01 | Sparky | HSV | 20171215_calibration | 3344,3669 | 17964,18455 | 21615,22105 | 23668,23913 | 200 |  | 20171220_251 | 20171220_251 | 20171220_251_tmaze | 0 | 1:8 | 0 | 1,1,1,1;1,1,1,1;1,1,1,1;1,1,1,1 | 1:8 | 0,0 | 1 | 1 | 1 |  | 1 |  | t_maze | 1,358049 | 0,0
0258 | 171220 |  | 01 | Pickles | HSV | 20171215_calibration | 3344,3669 | 17964,18455 | 21615,22105 | 23668,23913 | 200 |  | 20171220_258 | 20171220_258 | 20171220_258_tmaze | 0 | 1:8 | 0 | 1,1,1,1;1,1,1,1;1,1,1,1;1,1,1,1 | 1:8 | 0,0 | 1 | 1 | 1 |  | 1 |  | t_maze | 1,218406 | 0,0
0392 | 171222 |  | 01 | shoshana | HSV | 20171215_calibration | 3344,3669 | 17964,18455 | 21615,22105 | 23668,23913 | 200 |  | 20171222_392 | 20171222_392 | 20171222_392_tmaze | 0 | 1:8 | 0 | 1,1,1,1;1,1,1,1;1,1,1,1;1,1,1,1 | 1:8 | 0,0 | 1 | 1 | 1 |  | 1 |  | t_maze | 1,565521 | 0,0
0269 | 171222 |  | 01 | chocho | HSV | 20171215_calibration | 3344,3669 | 17964,18455 | 21615,22105 | 23668,23913 | 200 |  | 20171222_269 | 20171222_269 | 20171222_269_tmaze | 0 | 1:8 | 0 | 1,1,1,1;1,1,1,1;1,1,1,1;1,1,1,1 | 1:8 | 0,0 | 1 | 1 | 1 |  | 1 |  | t_maze | 1,777429 | 0,0
0148 | 171222 |  | 01 | psycho | HSV | 20171215_calibration | 3344,3669 | 17964,18455 | 21615,22105 | 23668,23913 | 200 |  | 20171222_148 | 20171222_148 | 20171222_148_cue | 0 | 1:8 | 0 | 1,1,1,1;1,1,1,1;1,1,1,1;1,1,1,1 | 1:8 | 0,0 | 1 | 1 | 1 |  | 1 |  | t_maze | 1,472319 | 0,0
0251 | 171222 |  | 01 | Sparky | HSV | 20171215_calibration | 3344,3669 | 17964,18455 | 21615,22105 | 23668,23913 | 200 |  | 20171222_251 | 20171222_251 | 20171222_251_cue | 0 | 1:8 | 0 | 1,1,1,1;1,1,1,1;1,1,1,1;1,1,1,1 | 1:8 | 0,0 | 1 | 1 | 1 |  |  |  | cue | 1,352248 | 0,0 |  |  |  |  |  |  | cue following
0392 | 171225 |  | 01 | shoshana | HSV | 20171215_calibration | 3344,3669 | 17964,18455 | 21615,22105 | 23668,23913 | 200 |  | 20171225_392 | 20171225_392 | 20171225_392_tmaze | 0 | 1:8 | 0 | 1,1,1,1;1,1,1,1;1,1,1,1;1,1,1,1 | 1:8 | 0,0 | 1 | 1 | 1 |  | 1 |  | t_maze | 1,790010 | 0,0
0269 | 171225 |  | 01 | chocho | HSV | 20171215_calibration | 3344,3669 | 17964,18455 | 21615,22105 | 23668,23913 | 200 |  | 20171225_269 | 20171225_269 | 20171225_269_tmaze | 0 | 1:8 | 0 | 1,1,1,1;1,1,1,1;1,1,1,1;1,1,1,1 | 1:8 | 0,0 | 1 | 1 | 1 |  | 1 |  | t_maze | 1,453752 | 0,0
0148 | 171225 |  | 01 | psycho | HSV | 20171215_calibration | 3344,3669 | 17964,18455 | 21615,22105 | 23668,23913 | 200 |  | 20171225_148 | 20171225_148 | 20171225_148_tmaze | 0 | 1:8 | 0 | 1,1,1,1;1,1,1,1;1,1,1,1;1,1,1,1 | 1:8 | 0,0 | 1 | 1 | 1 |  | 1 |  | t_maze | 1,40673 | 0,0
0251 | 171225 |  | 01 | Sparky | HSV | 20171215_calibration | 3344,3669 | 17964,18455 | 21615,22105 | 23668,23913 | 200 |  | 20171225_251 | 20171225_251 | 20171225_251_cue | 0 | 1:8 | 0 | 1,1,1,1;1,1,1,1;1,1,1,1;1,1,1,1 | 1:8 | 0,0 | 1 | 1 | 1 |  |  |  | cue | 1,236800 | 0,0 |  |  |  |  |  |  | cue following
0258 | 171225 |  | 01 | Pickles | HSV | 20171215_calibration | 3344,3669 | 17964,18455 | 21615,22105 | 23668,23913 | 200 |  | 20171225_258 | 20171225_258 | 20171225_258_cue | 0 | 1:8 | 0 | 1,1,1,1;1,1,1,1;1,1,1,1;1,1,1,1 | 1:8 | 0,0 | 1 | 1 | 1 |  |  |  | cue | 1,258644 | 0,0 |  |  |  |  |  |  | cue following
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

Sheet: Cells
cell_number | animal | day | experiment | TT | cell_id | comments | cell_duplicates

Sheet: lists_source
session_list | experiment |  |  | instructions: press F9. copy and paste values only . Save As date in videos folder |  |  |  |  |  |  |  |  | 1
place | 1 |  |  |  | pseudorandom |  |  |  |  |  |  | 4 |  | 2
response | 2 | response | response | place | place |  | Trial # | Baited arm number |  | Values only |  |  | 3
foraging | 3 |  | 3 |  |  | 1 | 1 | 1 | 2
 |  |  | 4 |  |  | 2 | 2 | 1 | 1
corner_list |  |  | 1 |  |  | 3 | 3 | 1 | 2 |  |  |  | 1
NW |  |  | 3 |  |  | 4 | 4 | 2 | 2
NE |  |  | 4 |  |  |  | 5 | 1 | 3
SE |  |  | 3 |  |  |  | 6 | 1 | 3
SW |  |  | 2 |  |  |  | 7 | 2 | 3
- |  |  | 2 |  |  |  | 8 | 2 | 4
 |  |  | 2 |  |  |  | 9 | 2 | 3
 |  |  | 2 |  |  |  | 10 | 2 | 4
REF_CSC |  |  | 1 |  |  |  | 11 | 1 | 1
1 |  |  | 2 |  |  |  | 12 | 2 | 2
2 |  |  | 3 |  |  |  | 13 | 2 | 3
3 |  |  | 2 |  |  |  | 14 | 2 | 1
4 |  |  | 3 |  |  |  | 15 | 2 | 1
5 |  |  | 4 |  |  |  | 16 | 2 | 4
6 |  |  | 2 |  |  |  | 17 | 1 | 2
7 |  |  | 2 |  |  |  | 18 | 1 | 1
8 |  |  | 1 |  |  |  | 19 | 1 | 1
9 |  |  | 3 |  |  |  | 20 | 1 | 4
10 |  |  | 4 |  |  |  | 21 | 2 | 3
11 |  |  | 3 |  |  |  | 22 | 2 | 4
12 |  |  | 3 |  |  |  | 23 | 2 | 3
13 |  |  | 2 |  |  |  | 24 | 1 | 1
14 |  |  | 3 |  |  |  | 25 | 1 | 2
15 |  |  | 2 |  |  |  | 26 | 2 | 1
16 |  |  | 2 |  |  |  | 27 | 1 | 2
17
18
19
20
21
22
23 |  |  |  | 1 | N | aN | 3 | 2 N | aN | 4 | 2
24 |  |  |  |  | 2 | NaN | 1 | 4 | NaN | 4 | 2
25 |  |  |  |  | 3 | NaN | 2 | 1 | NaN | 4 | 2
26 |  |  |  |  | 4 | NaN | 4 | 3 | NaN | 4 | 2
27 |  |  |  |  | 5 | NaN | 4 | 3 | NaN | 4 | 2
28 |  |  |  |  | 6 | NaN | 2 | 1 | NaN | 4 | 2
29 |  |  |  |  | 7 | NaN | 4 | 3 | NaN | 1 | 2
30 |  |  |  |  | 8 | NaN | 1 | 4 | NaN | 1 | 2
31 |  |  |  |  | 9 | NaN | 3 | 2 | NaN | 4 | 2
32 |  |  |  |  | 10 | NaN | 3 | 2 | NaN | 1 | 2
 |  |  |  |  | 11 | NaN | 1 | 4 | NaN | 3 | 2
 |  |  |  |  | 12 | NaN | 2 | 1 | NaN | 3 | 2
 |  |  |  |  | 13 | NaN | 1 | 4 | NaN | 3 | 2
 |  |  |  |  | 14 | NaN | 2 | 1 | NaN | 1 | 2
 |  |  |  |  | 15 | NaN | 4 | 3 | NaN | 4 | 2
 |  |  |  |  | 16 | NaN | 3 | 2 | NaN | 4 | 2
 |  |  |  |  | 17 | NaN | 4 | 3 | NaN | 1 | 2
 |  |  |  |  | 18 | NaN | 4 | 3 | NaN | 4 | 2
 |  |  |  |  | 19 | NaN | 2 | 1 | NaN | 3 | 2
 |  |  |  |  | 20 | NaN | 3 | 2 | NaN | 1 | 2
 |  |  |  |  | 21 | NaN | 4 | 3 | NaN | 1 | 2
 |  |  |  |  | 22 | NaN | 1 | 4 | NaN | 3 | 2
 |  |  |  |  | 23 | NaN | 2 | 1 | NaN | 4 | 2
 |  |  |  |  | 24 | NaN | 2 | 1 | NaN | 4 | 2
 |  |  |  |  | 25 | NaN | 1 | 4 | NaN | 1 | 2
 |  |  |  |  | 26 | NaN | 1 | 4 | NaN | 1 | 2
 |  |  |  |  | 27 | NaN | 4 | 3 | NaN | 4 | 2
