WeissShahaf/LizardPlusMaze/MazeDesignFiles/Maze.PDF

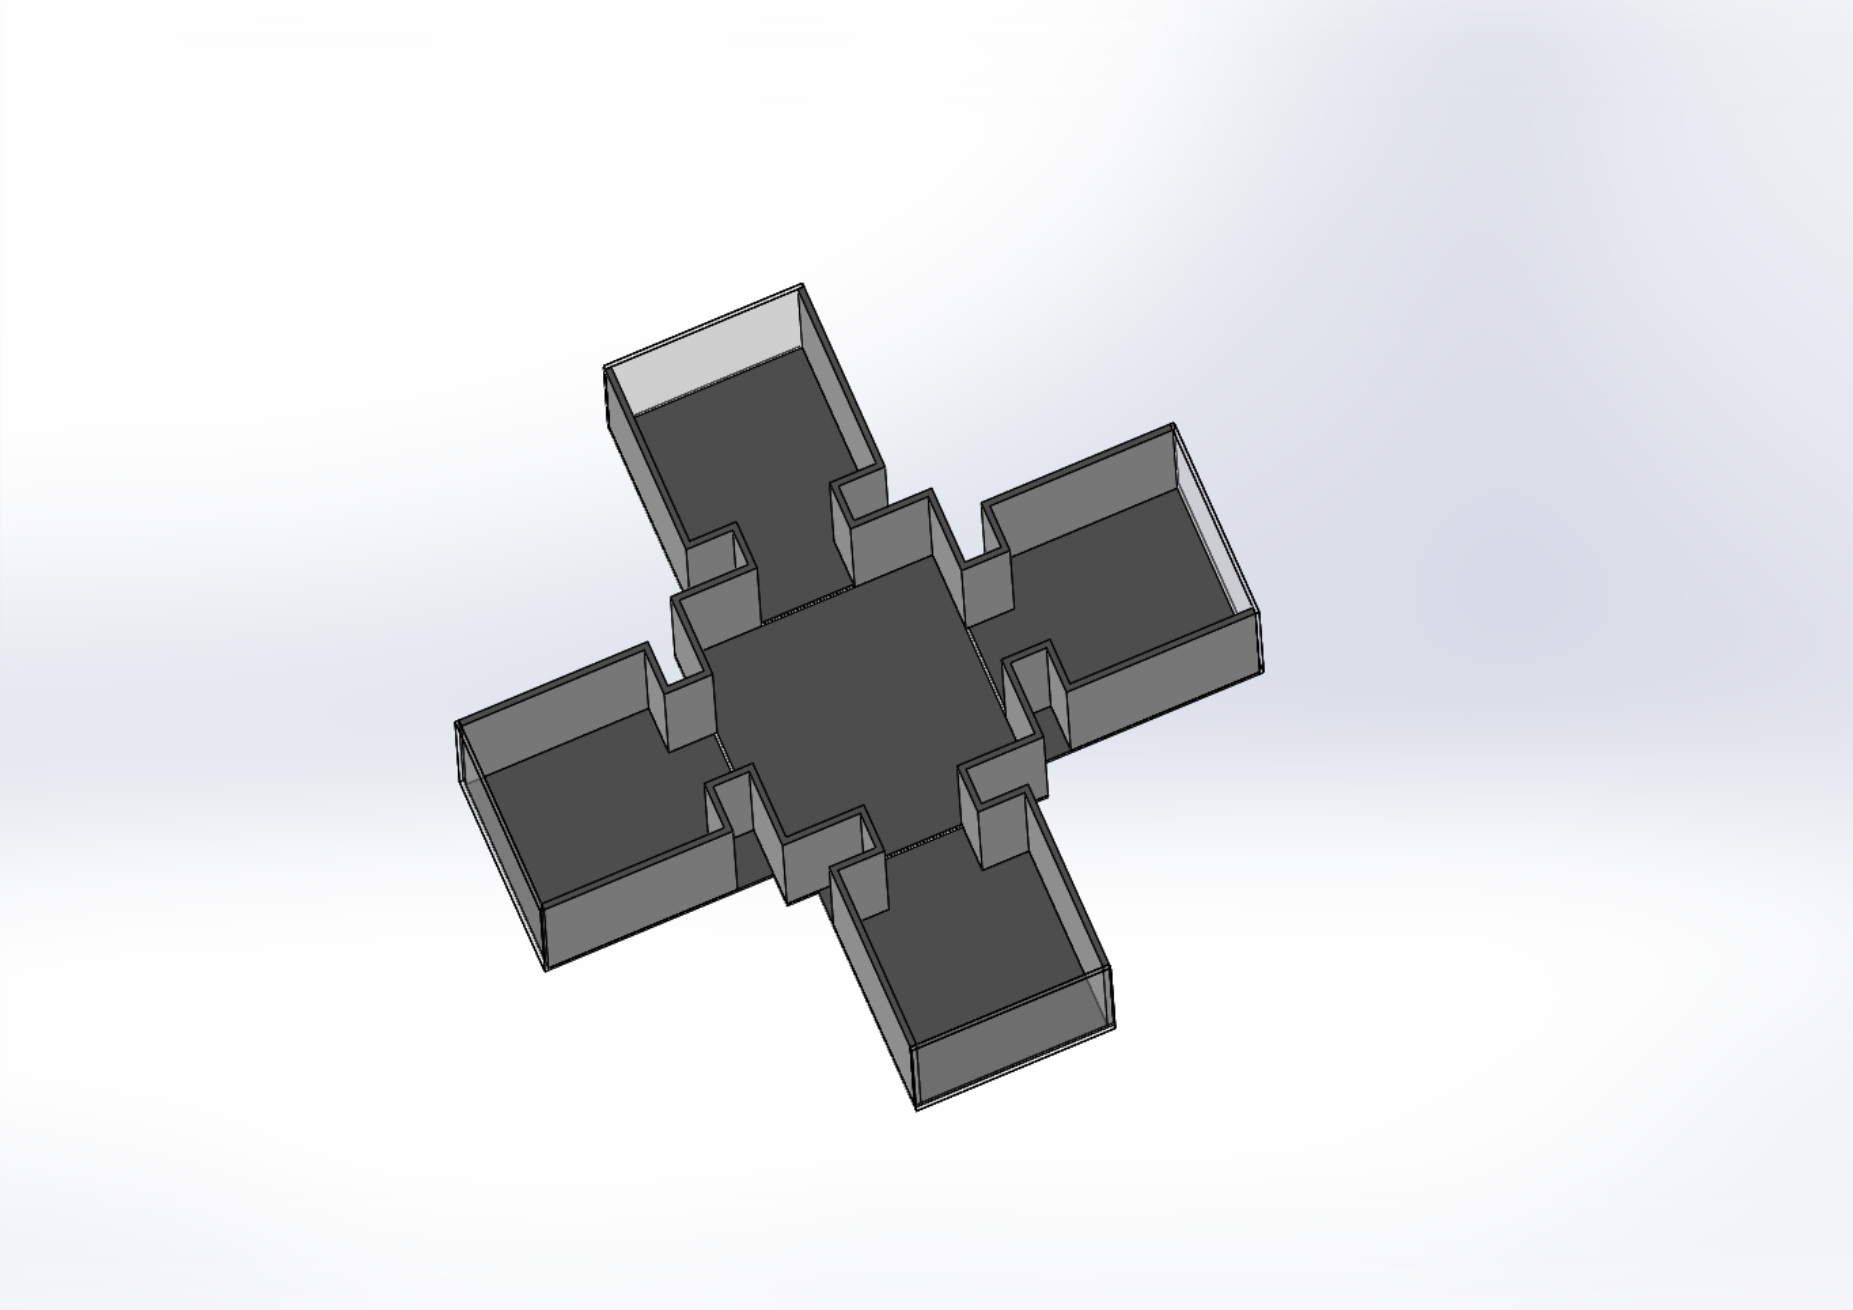
[picture p5: page 1]
