WeissShahaf/LizardPlusMaze/MazeDesignFiles/Maze_drawing.PDF

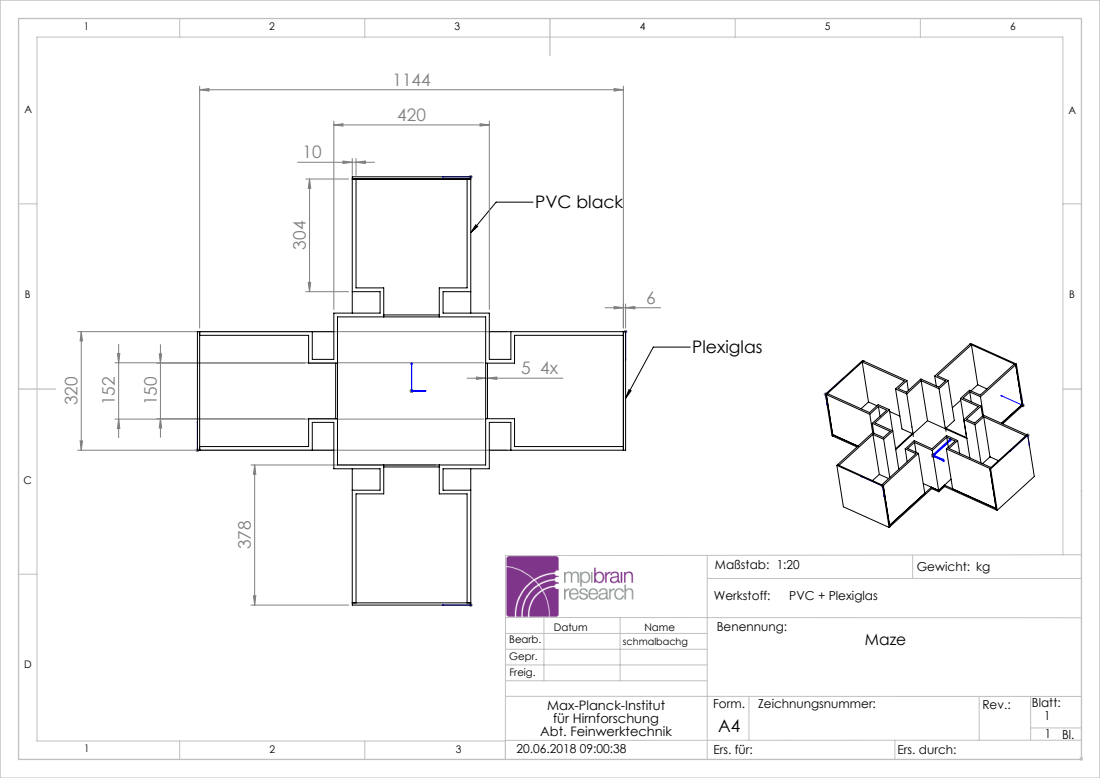
[picture p6: page 1]
PVC black; Ers. für:; Ers. durch:; PVC + Plexiglas

Datum | Name | Benennung: Maze

Bearb. | | schmalbachg
Gepr.
Freig.

Max-Planck-Institut
für Hirnforschung
Abt. Feinwerktechnik
