WeissShahaf/LizardPlusMaze/MazeDesignFiles/round_Arena.PDF

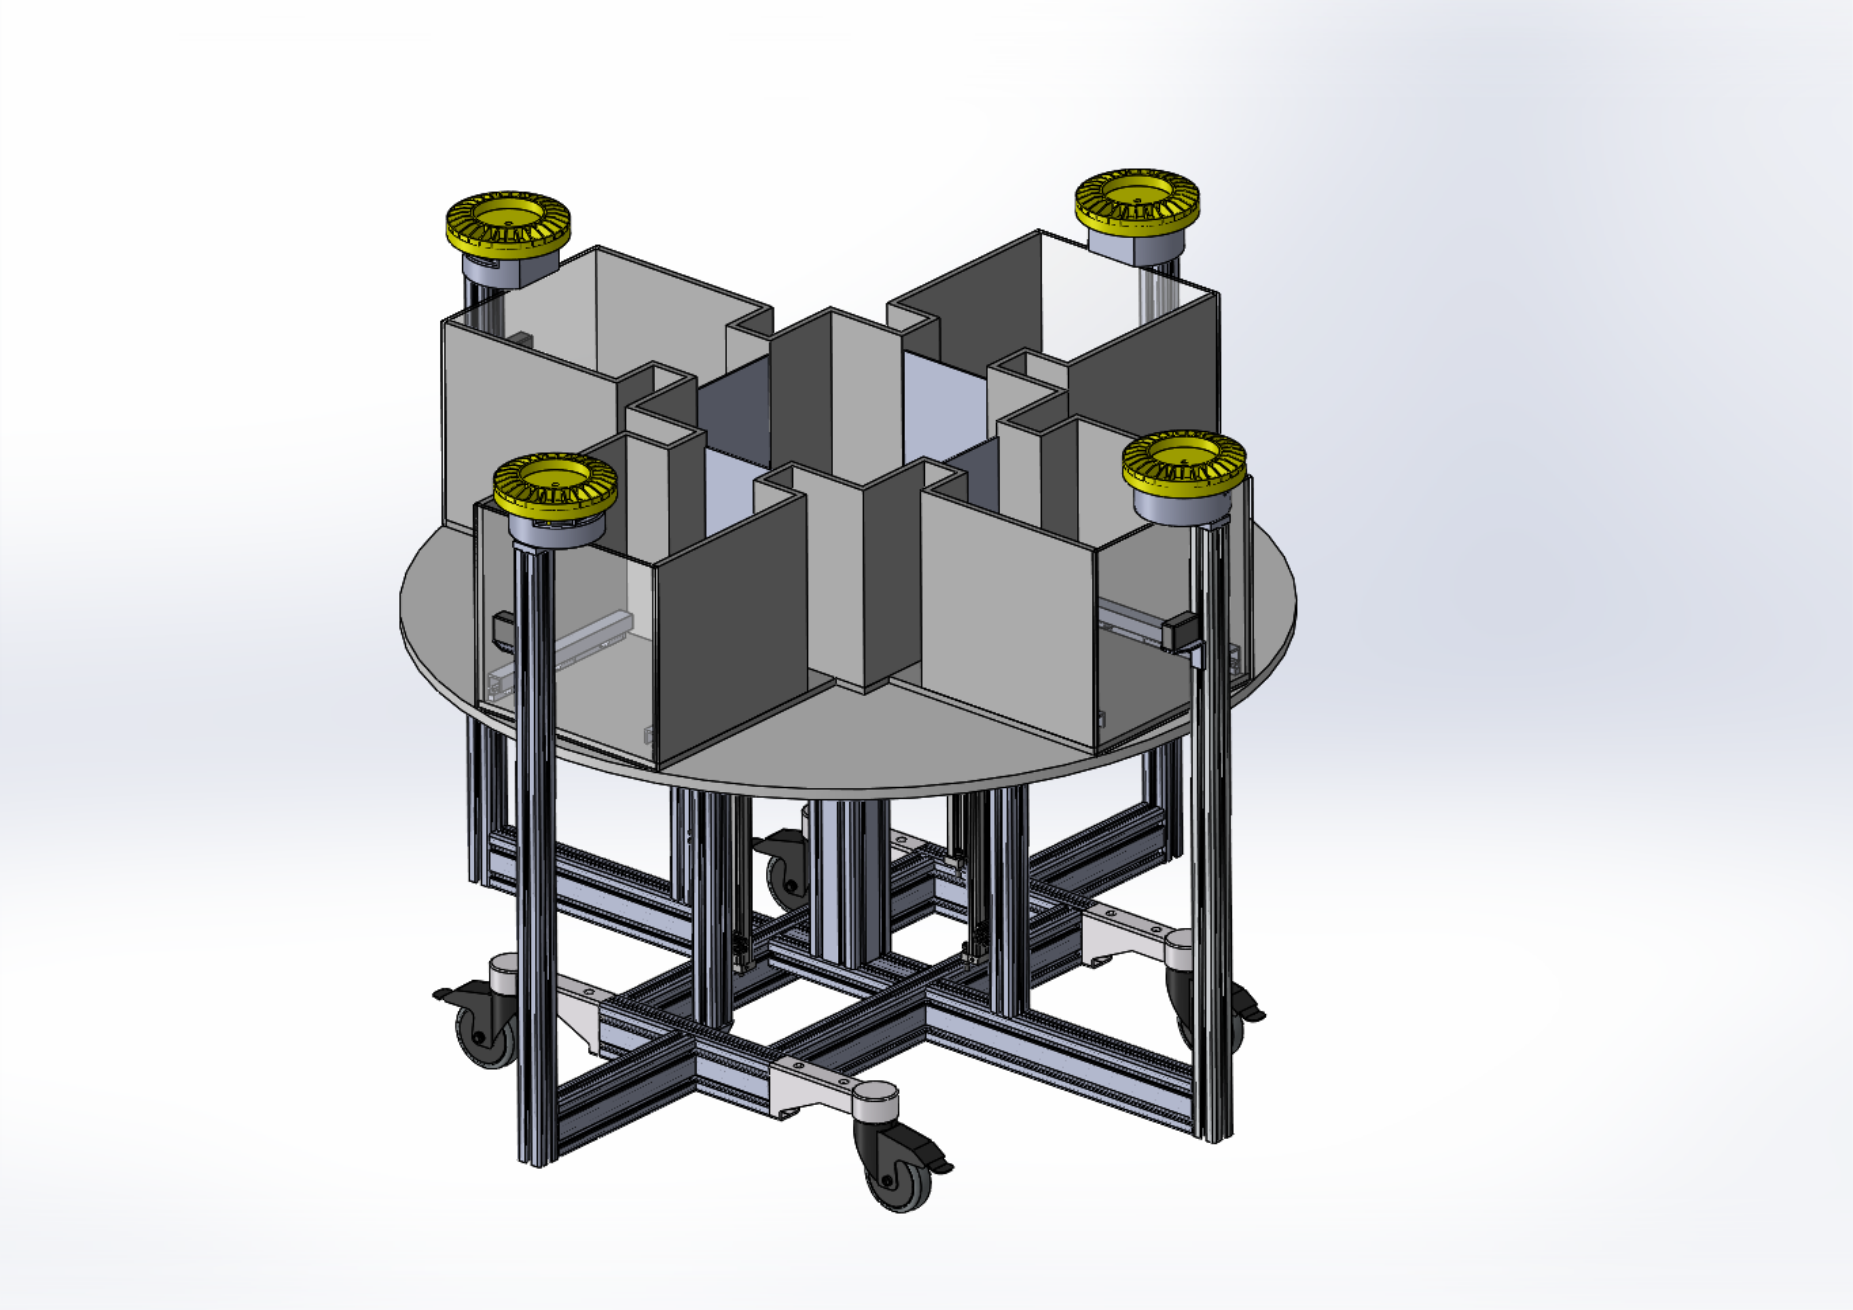
[picture p7: page 1]
