WeissShahaf/LizardPlusMaze/MazeDesignFiles/round_Arena2.PDF

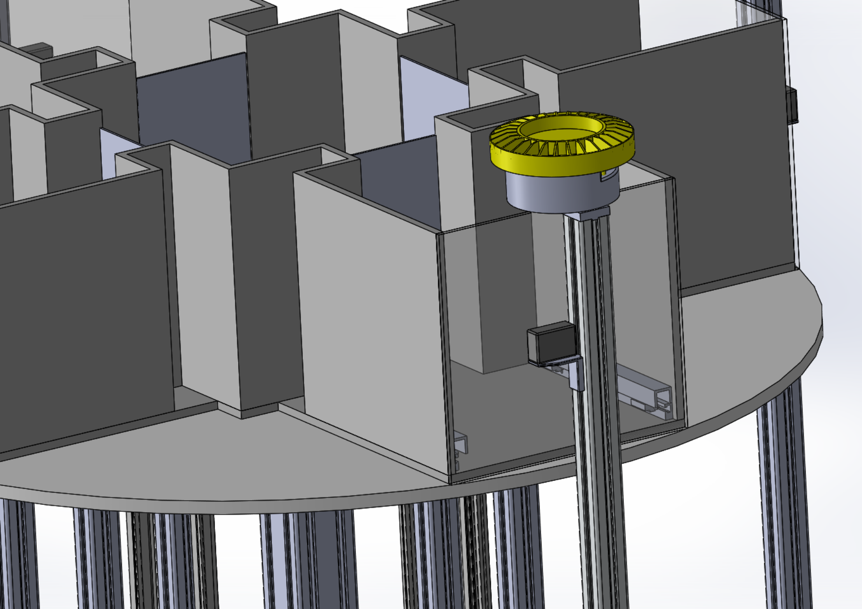
[picture p8: page 1]
