WeissShahaf/LizardPlusMaze/(commit log)

2019-04-10 1st commit- unsorted files
    [Arduino Mapping.xlsx, TTLs_map.xlsx, cams_list.xlsx, cams_list2.xlsx, electronics parts list.xlsx, inclusion_list_lizard_plusmaze.xls]
2019-04-10 orgnaized files into a more readable format
    [Verkabelung.xlsx, arduino pinlayout.xlsx]
